scottjulian/OpenTread/hardware/opentread-cyd-case.stl

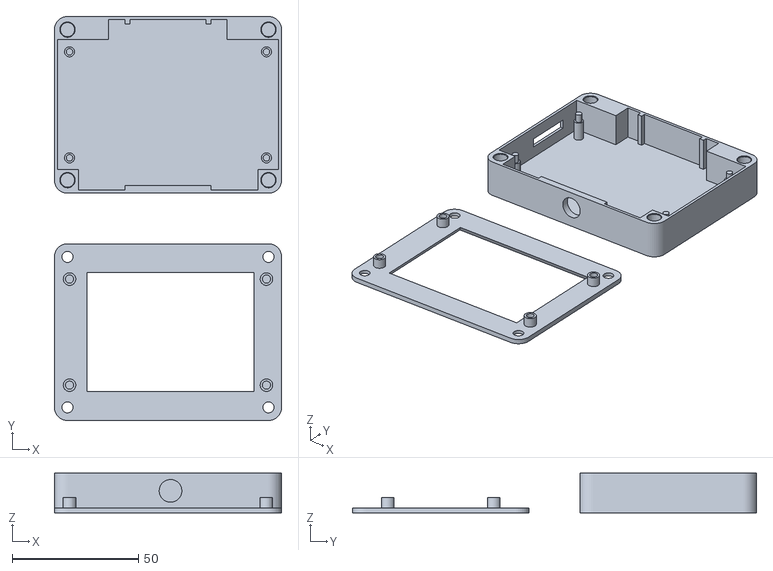
[picture p7: CAD file, 2026-11-01]
hardware/opentread-cyd-case.stl
90.0 x 160.0 x 15.7
