scottjulian/OpenTread/firmware/opentread/test/data/2026-10-18_1315_bench_jumper.csv

# capture_m4.py host_start=2026-10-18T13:15:34-06:00 port=/dev/cu.usbserial-110 baud=115200 session=bench_jumper m_per_pulse=0.62
ets Jul 29 2019 12:21:46
rst:0x1 (POWERON_RESET) | boot:0x13 (SPI_FAST_FLASH_BOOT)
configsip: 0 | SPIWP:0xee
clk_drv:0x00 | q_drv:0x00 | d_drv:0x00 | cs0_drv:0x00 | hd_drv:0x00 | wp_drv:0x00
mode:DIO | clock div:1
load:0x3fff0030 | len:4876
ho 0 tail 12 room 4
load:0x40078000 | len:16532
load:0x40080400 | len:3500
entry 0x400805b4
S | 14260 | M4 pulse logger v1 pin=27 lockout_us=20000 release_us=5000 baud=115200 line_level=1 ring=2048 marker_pin=0 reset_reason=1
S | 14260 | format: E;t;level P;t;n;dt_us F;t;hex M;t;n S;t;text H;t;pulses;edges;drop_e;ftms;drop_f;conn;level
S | 296544 | scan start (boot) for 'AssaultRunner*' - press CONNECT on the console
H | 5299348 | 0 | 0 | 0 | 0 | 0 | 0 | 1
H | 10299347 | 0 | 0 | 0 | 0 | 0 | 0 | 1
H | 15299347 | 0 | 0 | 0 | 0 | 0 | 0 | 1
H | 20299347 | 0 | 0 | 0 | 0 | 0 | 0 | 1
H | 25299347 | 0 | 0 | 0 | 0 | 0 | 0 | 1
H | 30299350 | 0 | 0 | 0 | 0 | 0 | 0 | 1
S | 30300355 | scan start (rescan) for 'AssaultRunner*' - press CONNECT on the console
H | 35299347 | 0 | 0 | 0 | 0 | 0 | 0 | 1
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
