scottjulian/OpenTread/firmware/opentread/test/data/2026-10-18_1323_S1_handturn.csv

# capture_m4.py host_start=2026-10-18T13:23:33-06:00 port=/dev/cu.usbserial-10 baud=115200 session=S1_handturn m_per_pulse=0.62
ets Jul 29 2019 12:21:46
rst:0x1 (POWERON_RESET) | boot:0x13 (SPI_FAST_FLASH_BOOT)
configsip: 0 | SPIWP:0xee
clk_drv:0x00 | q_drv:0x00 | d_drv:0x00 | cs0_drv:0x00 | hd_drv:0x00 | wp_drv:0x00
mode:DIO | clock div:1
load:0x3fff0030 | len:4876
ho 0 tail 12 room 4
load:0x40078000 | len:16532
load:0x40080400 | len:3500
entry 0x400805b4
S | 13494 | M4 pulse logger v1 pin=27 lockout_us=20000 release_us=5000 baud=115200 line_level=1 ring=2048 marker_pin=0 reset_reason=1
S | 13494 | format: E;t;level P;t;n;dt_us F;t;hex M;t;n S;t;text H;t;pulses;edges;drop_e;ftms;drop_f;conn;level
S | 281535 | scan start (boot) for 'AssaultRunner*' - press CONNECT on the console
H | 5284339 | 0 | 0 | 0 | 0 | 0 | 0 | 1
H | 10284337 | 0 | 0 | 0 | 0 | 0 | 0 | 1
S | 11628506 | BLE connecting to fd:a6:3b:08:67:e5 (timeout 5000 ms)
S | 11628505 | scan match: AssaultRunner850809 [fd:a6:3b:08:67:e5]
S | 12052842 | BLE connected mtu=70
S | 12653069 | BLE subscribed to Treadmill Data mtu=70
F | 12752974 | a61400000000000000000000ffffff0800ff7f0000
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
