scottjulian/OpenTread/firmware/opentread/test/data/2026-10-18_1416_S1b_10rev.csv

# capture_m4.py host_start=2026-10-18T14:16:43-06:00 port=/dev/cu.usbserial-10 baud=115200 session=S1b_10rev m_per_pulse=0.62
ets Jul 29 2019 12:21:46
rst:0x1 (POWERON_RESET) | boot:0x13 (SPI_FAST_FLASH_BOOT)
configsip: 0 | SPIWP:0xee
clk_drv:0x00 | q_drv:0x00 | d_drv:0x00 | cs0_drv:0x00 | hd_drv:0x00 | wp_drv:0x00
mode:DIO | clock div:1
load:0x3fff0030 | len:4876
ho 0 tail 12 room 4
load:0x40078000 | len:16532
load:0x40080400 | len:3500
entry 0x400805b4
S | 12784 | M4 pulse logger v1 pin=27 lockout_us=20000 release_us=5000 baud=115200 line_level=1 ring=2048 marker_pin=0 reset_reason=1
S | 12784 | format: E;t;level P;t;n;dt_us F;t;hex M;t;n S;t;text H;t;pulses;edges;drop_e;ftms;drop_f;conn;level
S | 290534 | scan start (boot) for 'AssaultRunner*' - press CONNECT on the console
H | 5293338 | 0 | 0 | 0 | 0 | 0 | 0 | 1
H | 10293337 | 0 | 0 | 0 | 0 | 0 | 0 | 1
M | 14104259 | 1
H | 15293337 | 0 | 0 | 0 | 0 | 0 | 0 | 1
E | 18578332 | 0
P | 18578332 | 1 | 0
E | 18648948 | 1
E | 18648950 | 1
E | 19725310 | 0
P | 19725310 | 2 | 1146978
E | 19770123 | 1
E | 19770125 | 1
H | 20293337 | 2 | 6 | 0 | 0 | 0 | 0 | 1
E | 20731330 | 0
P | 20731330 | 3 | 1006020
E | 20781199 | 1
E | 20781201 | 1
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
