scottjulian/OpenTread/tools/touch_cal.py

#!/usr/bin/env python3
"""Touch calibration from a touch bring-up log (OT_BRINGUP=1 build).

Run with the pinned interpreter, standard library only (writes nothing):

    .venv/bin/python -I tools/touch_cal.py logs/<date>_<time>_<session>.csv
    .venv/bin/python -I tools/touch_cal.py presses.csv --size 320x240 --reff 1
    .venv/bin/python -I tools/touch_cal.py LOG --require-grid      # acceptance run
    .venv/bin/python -I tools/touch_cal.py --self-test

What it computes (from presses whose raw values come from lcd.getTouchRaw()):
  1. Screen-frame fit at the chosen rotation, from the 4 corner + centre
     presses: which raw axis drives screen x / y (axis SWAP) and whether raw
     decreases as the screen coordinate grows (INVERSION); the raw value at
     each screen edge.
  2. The LovyanGFX Touch_XPT2046 config (x_min/x_max/y_min/y_max, i.e. the
     TOUCH_X/Y_MIN/MAX constants) in the library's NATIVE touch frame. These
     depend on the library's effective touch rotation r_eff, taken from touchcfg
     (rot/poff/toff), --reff, or inferred from logged sx/sy.
  3. The 3x3 grid error with those (integer, rounded) constants, through the
     exact LovyanGFX 1.2.26 pipeline (Panel_Device::setCalibrate +
     convertRawXY: per-axis linear map, truncation to int, then r_eff
     swap/flip). Acceptance: every grid point |dx| <= 15 and |dy| <= 15 px.
     Without grid presses: calibration residuals and leave-one-out errors.
  4. TOUCH_Z_MIN from the labelled light/normal/firm x dry/damp presses
     (rule below).

------------------------------------------------------------------------------
INPUT CONTRACT (the firmware's OT_BRINGUP=1 touch screen must produce this;
emitted by firmware/opentread/hw_display.cpp; summarised in its README)
------------------------------------------------------------------------------
Log input = a tools/capture.py log (verbatim serial). Only lines containing one
of the tags `touchcal;`, `touchraw;` or `touchcfg;` are used; every other line
(boot ROM noise, E/P/H/K/D/G/T lines, torn lines) is ignored. Normally these
are S lines, so commas in the text are already ';':

  S,<t_us>,touchcfg;rot=1 poff=2 toff=0 w=320 h=240 pw=240 ph=320 x_min=300 x_max=3900 y_min=3700 y_max=200 zth=0 inset=20 reff=3
  S,<t_us>,touchcal;tgt=tl tx=20 ty=20 x=3712 y=402 z=44 zmin=41 n=25 sx=19 sy=22
  S,<t_us>,touchcal;tgt=z press=light finger=damp x=2010 y=2050 z=39 zmin=37 n=31
  S,<t_us>,touchraw;tgt=g4 tx=160 ty=120 x=2050 y=1980 z=45 sx=161 sy=118

After the tag, the payload is key=value tokens separated by spaces and/or ';'
(order free, unknown keys ignored, keys case-insensitive). Values are
integers (decimals accepted).

touchcfg (optional but strongly recommended; print once at bring-up start and
again whenever any field changes; a press uses the last touchcfg before it):
  rot      lcd.setRotation() value used for the bring-up screen (0..7)
  poff     Panel offset_rotation compiled into LGFX_CYD (0..7)
  toff     Touch_XPT2046 offset_rotation compiled into LGFX_CYD (0..7)
  w,h      logical screen size at rot (lcd.width(), lcd.height())
  pw,ph    panel_width/panel_height in the panel config (240, 320)
  x_min,x_max,y_min,y_max  Touch_XPT2046 config values live NOW (compiled, or
           applied in RAM with setTouchRanges, e.g. the bring-up's 'ka')
  zth      the z threshold the bring-up applied before logging (0 = none)
  inset    corner-target inset in px (only used when tx/ty are absent)
  reff     optional: the effective touch rotation if the firmware computes it
           (else derived from rot/poff/toff with LovyanGFX's own formula)
touchcal (one line per press; the firmware aggregates the samples it took
while the finger was held):
  tgt      target name (required): tl tr bl br c (calibration);
           g0..g8 (3x3 grid, row-major from top-left; g<r><c> also accepted);
           z (pressure test, with press= and finger=; or z_<press>_<finger>);
           any other name with tx/ty = extra check point
  x,y      raw from lcd.getTouchRaw() (median over the held samples; the
           library's own value is already a median of 7 reads) (required)
  z        tp.size from getTouchRaw (median) (required for the z rule)
  zmin     smallest size seen while held, after dropping the first/last 2
           samples (optional; the z rule uses it when present)
  tx,ty    the drawn target centre in logical screen px at rot (strongly
           recommended; defaults: corners at the inset, centre w/2,h/2, grid
           at (2c+1)w/6, (2r+1)h/6)
  sx,sy    lcd.convertRawXY() of the SAME raw x,y (copy the touch_point_t,
           convert the copy), with the compiled constants. NOT a second
           getTouch() call (that is a new, different sample). Optional: used
           to infer/verify r_eff and the library model, and to report the
           device-side grid error.
  press    light | normal | firm   (z tests; optional on other targets)
  finger   dry | damp
  n        samples aggregated (informational)
touchraw (one line per sample while held; the tool groups samples into
presses): same keys as touchcal (z per sample, no zmin/n). A press = a run of
consecutive touchraw lines with the same tgt/press/finger (and id= if given)
whose S-line timestamps are <= 150 ms apart. The first/last 2 samples of a
press are dropped when it has >= 7; then x,y,z = median, zmin = minimum.
Samples with valid=0 are skipped.

RUNS: every `screen;<name>` S line (printed when the firmware switches screens,
e.g. on kc, kg, z<label>, m, r<n>) starts a new run. The firmware restarts the
target sequence on every kc/kg, so, like its own cal;suggest, the tool fits
ONLY the last complete calibration run (all 5 of tl tr br bl c) and scores
ONLY the last complete 3x3 grid run (all 9); earlier runs (a redone kc or kg)
are discarded and counted in the output. Without screen lines (CSV input or
older logs) everything is one run. z presses from every run are used.

CSV input (alternative): a header line with at least target,x_raw,y_raw,z
(aliases: tgt, x, y, size); optional columns tx,ty,sx,sy,zmin,press,finger,n.
'#' lines are comments; a '#' line containing `touchcfg;` is parsed as above.
Each row is one press.

------------------------------------------------------------------------------
TOUCH_Z_MIN RULE
------------------------------------------------------------------------------
z is LovyanGFX's tp.size = (0x3200 + y - x + ((z1 - z2) >> 1)) >> 8 (median
of 7), so it depends on POSITION as well as pressure (raw y - x spans ~+-3700,
i.e. ~+-14 size units, comparable to the light..firm spread). Therefore:
  a. Position model f(x,y) = bx*x + by*y. Fitted by least squares on the
     calibration/grid presses plus presses labelled normal, when there are
     >= 9 of them spanning >= 1500 raw units in both x and y; otherwise the
     library's explicit term (bx, by) = (-1/256, +1/256).
  b. Every deliberate press i (all labelled presses AND all calibration/grid
     presses) is moved to the worst position on the screen:
         z_worst_i = zuse_i + min over the 4 screen corners c of f(c) - f(p_i)
     where zuse = zmin if logged, else z, and the corners' raw values come
     from the screen-frame fit.
  c. L = min_i z_worst_i (the weakest deliberate press at the worst place).
     TOUCH_Z_MIN = max(1, floor(L) - Z_MARGIN), Z_MARGIN = 2 size units (one
     unit of >>8 quantisation plus one of headroom). The touch debounce
     (3 consecutive valid samples, 120 ms release bridge) handles noise, so
     the threshold is biased to ACCEPT light/damp presses.
  Warnings: a light/normal/firm x dry/damp class missing; per-finger medians
  not light <= normal <= firm; the weakest raw z within 1 unit of the
  bring-up's zth (light presses may have been censored: rerun with zth=0).

TOUCH_Z_MIN needs the screen fit (the kc presses) in the SAME capture as the
z presses: without it no recommendation is printed (FAIL).

Exit code: 0 = calibration computed and, if grid presses exist, all within
tolerance; 1 = grid out of tolerance, missing/insufficient calibration,
inconsistent rotation, or --require-grid without a full grid; 2 = usage or
file error. --self-test runs synthetic cases (all 8 r_eff values incl.
rotated and inverted axes, each input format, injected faults).
"""
from __future__ import annotations

import argparse
import csv
import math
import os
import random
import re
import statistics
import sys
from dataclasses import dataclass, field

sys.dont_write_bytecode = True

# --------------------------------------------------------------------------
# Constants
# --------------------------------------------------------------------------
DEFAULT_W, DEFAULT_H = 320, 240        # landscape (rotation 1 or 3) logical screen
DEFAULT_PW, DEFAULT_PH = 240, 320      # ILI9341 panel_width / panel_height
START_CFG = {"x_min": 300, "x_max": 3900, "y_min": 3700, "y_max": 200}  # uncalibrated start values
DEFAULT_INSET = 20
GRID_TOL_PX = 15                       # acceptance: 3x3 grid within +-15 px
RAW_VALID_LO, RAW_VALID_HI = 129, 3968 # Touch_XPT2046::getTouchRaw keeps 128 < v <= 3968
Z_MARGIN = 2
GAP_MS = 150
TRIM = 2
TRIM_MIN_SAMPLES = 2 * TRIM + 3
LIB_BX, LIB_BY = -1.0 / 256.0, 1.0 / 256.0
POS_FIT_MIN_N, POS_FIT_MIN_SPAN = 9, 1500
MODEL_TOL_PX = 2.5                     # sx/sy vs exact library model, rms
PRESS_CLASSES = ("light", "normal", "firm")
FINGERS = ("dry", "damp")
CAL_TARGETS = ("tl", "tr", "bl", "br", "c")
GRID_TARGETS = tuple(f"g{i}" for i in range(9))

_ALIASES = {"ul": "tl", "lt": "tl", "topleft": "tl", "top_left": "tl",
            "ur": "tr", "rt": "tr", "topright": "tr", "top_right": "tr",
            "ll": "bl", "lb": "bl", "bottomleft": "bl", "bottom_left": "bl",
            "lr": "br", "rb": "br", "bottomright": "br", "bottom_right": "br",
            "cc": "c", "ctr": "c", "center": "c", "centre": "c", "mid": "c", "m": "c"}
_KEY_ALIASES = {"target": "tgt", "x_raw": "x", "y_raw": "y", "xr": "x", "yr": "y",
                "rx": "x", "ry": "y", "size": "z", "z_raw": "z", "pressure": "press",
                "z_min": "zmin", "rotation": "rot"}
_TAG_RE = re.compile(r"(?:^|[\s;:,])(touchcal|touchraw|touchcfg)[;:\s]")
_SCREEN_RE = re.compile(r"(?:^|[\s;:,])screen;([a-z_]+)")
_S_RE = re.compile(r"^S,(\d+),")
_NUM_RE = re.compile(r"^[+-]?\d+(\.\d+)?$")


class InputError(Exception):
    pass


# --------------------------------------------------------------------------
# Data
# --------------------------------------------------------------------------
@dataclass
class Cfg:
    rot: int | None = None
    poff: int | None = None
    toff: int | None = None
    reff: int | None = None
    w: int = DEFAULT_W
    h: int = DEFAULT_H
    pw: int = DEFAULT_PW
    ph: int = DEFAULT_PH
    consts: dict | None = None       # x_min.. compiled in the firmware (None = unknown)
    zth: float | None = None
    inset: int = DEFAULT_INSET
    line: int = 0

    def geom_key(self):
        return (self.rot, self.poff, self.toff, self.reff, self.w, self.h, self.pw, self.ph)


@dataclass
class Press:
    tgt: str
    kind: str                      # cal | grid | z | check
    x: float
    y: float
    z: float | None
    zmin: float | None = None
    tx: float | None = None
    ty: float | None = None
    sx: float | None = None
    sy: float | None = None
    press: str | None = None
    finger: str | None = None
    n: int = 1
    line: int = 0
    cfg: Cfg = field(default_factory=Cfg)
    default_target: bool = False
    run: int = 0                   # screen run (see RUNS in the header)


@dataclass
class Capture:
    presses: list
    cfgs: list
    warnings: list
    n_bad: int = 0
    n_tagged: int = 0
    fmt: str = "log"


def combine_rot(a: int, b: int) -> int:
    """LovyanGFX: ((r + offset) & 3) | ((r & 4) ^ (offset & 4))."""
    return ((a + b) & 3) | ((a & 4) ^ (b & 4))


def vflip(r: int) -> bool:
    return bool((1 << r) & 0b10010110)          # r = 1, 2, 4, 7


def cfg_reff(cfg: Cfg):
    if cfg.reff is not None:
        return cfg.reff & 7
    if cfg.rot is None:
        return None
    panel_r = combine_rot(cfg.rot & 7, (cfg.poff or 0) & 7)
    return combine_rot(panel_r, (cfg.toff or 0) & 7)


def touch_dims(cfg: Cfg, toff=None):
    toff = cfg.toff if toff is None else toff
    return (cfg.ph, cfg.pw) if (toff or 0) & 1 else (cfg.pw, cfg.ph)


def reff_valid(r: int, cfg: Cfg) -> bool:
    tw, th = touch_dims(cfg)
    return ((th, tw) if r & 1 else (tw, th)) == (cfg.w, cfg.h)


# --------------------------------------------------------------------------
# Parsing (never raises on bad lines; counts them)
# --------------------------------------------------------------------------
def _num(v):
    v = v.strip()
    if not _NUM_RE.match(v):
        raise ValueError(v)
    f = float(v)
    return int(f) if f.is_integer() else f


def parse_kv(payload: str) -> dict:
    out = {}
    for tok in re.split(r"[;\s]+", payload.strip()):
        if "=" not in tok:
            continue
        k, _, v = tok.partition("=")
        k = k.strip().lower()
        k = _KEY_ALIASES.get(k, k)
        if k:
            out[k] = v.strip()
    return out


def canon_target(name: str, kv: dict):
    """-> (tgt, kind, press, finger)."""
    n = name.strip().lower()
    n = _ALIASES.get(n, n)
    press = (kv.get("press") or "").lower() or None
    finger = (kv.get("finger") or "").lower() or None
    if n in CAL_TARGETS:
        return n, "cal", press, finger
    m = re.fullmatch(r"g(\d)", n)
    if m:
        return f"g{m.group(1)}", "grid", press, finger
    m = re.fullmatch(r"g([0-2])([0-2])", n)
    if m:
        return f"g{3 * int(m.group(1)) + int(m.group(2))}", "grid", press, finger
    if n == "z" or n.startswith("z_") or n.startswith("z-"):
        for part in re.split(r"[_-]", n)[1:]:
            if part in PRESS_CLASSES:
                press = press or part
            elif part in FINGERS:
                finger = finger or part
        return "z", "z", press, finger
    if press in PRESS_CLASSES:
        return n, "z", press, finger
    return n, "check", press, finger


def _cfg_from_kv(kv: dict, base: Cfg, line: int) -> Cfg:
    c = Cfg(rot=base.rot, poff=base.poff, toff=base.toff, reff=base.reff, w=base.w, h=base.h,
            pw=base.pw, ph=base.ph, consts=dict(base.consts) if base.consts else None,
            zth=base.zth, inset=base.inset, line=line)
    for k in ("rot", "poff", "toff", "reff"):
        if k in kv:
            setattr(c, k, int(_num(kv[k])))
    for k in ("w", "h", "pw", "ph", "inset"):
        if k in kv:
            setattr(c, k, int(_num(kv[k])))
    if "zth" in kv:
        c.zth = _num(kv["zth"])
    ck = [k for k in ("x_min", "x_max", "y_min", "y_max") if k in kv]
    if ck:
        if len(ck) != 4:
            raise ValueError("touchcfg needs all of x_min x_max y_min y_max")
        c.consts = {k: int(_num(kv[k])) for k in ("x_min", "x_max", "y_min", "y_max")}
    return c


def _press_from_kv(kv: dict, cfg: Cfg, line: int, need_z=False) -> Press:
    if "tgt" not in kv:
        raise ValueError("no tgt")
    tgt, kind, press, finger = canon_target(kv["tgt"], kv)
    x, y = _num(kv["x"]), _num(kv["y"])
    z = _num(kv["z"]) if kv.get("z", "") != "" else None
    if need_z and z is None:
        raise ValueError("no z")

    def opt(k):
        return _num(kv[k]) if kv.get(k, "") != "" else None
    return Press(tgt=tgt, kind=kind, x=x, y=y, z=z, zmin=opt("zmin"), tx=opt("tx"), ty=opt("ty"),
                 sx=opt("sx"), sy=opt("sy"), press=press, finger=finger,
                 n=int(opt("n") or 1), line=line, cfg=cfg)


def _group_raw(samples, warnings):
    """samples: [(t_us|None, line, kv, cfg, run)] in file order -> [Press]."""
    presses, cur, last_key, last_t = [], [], None, None

    def flush():
        if not cur:
            return
        ps = cur
        if len(ps) >= TRIM_MIN_SAMPLES:
            ps = ps[TRIM:-TRIM]
        base = ps[0][2]
        p = _press_from_kv(base, ps[0][3], ps[0][1])
        p.x = statistics.median(_num(s[2]["x"]) for s in ps)
        p.y = statistics.median(_num(s[2]["y"]) for s in ps)
        zs = [_num(s[2]["z"]) for s in ps if s[2].get("z", "") != ""]
        p.z = statistics.median(zs) if zs else None
        p.zmin = min(zs) if zs else None
        for k in ("sx", "sy"):
            vs = [_num(s[2][k]) for s in ps if s[2].get(k, "") != ""]
            setattr(p, k, statistics.median(vs) if vs else None)
        p.n = len(ps)
        p.run = ps[0][4]
        presses.append(p)

    for t, line, kv, cfg, run in samples:
        key = (kv.get("tgt", "").lower(), kv.get("press"), kv.get("finger"), kv.get("id"), id(cfg), run)
        gap = (t is not None and last_t is not None and t - last_t > GAP_MS * 1000)
        if key != last_key or gap:
            flush()
            cur = []
        cur.append((t, line, kv, cfg, run))
        last_key, last_t = key, t
    flush()
    return presses


def parse_lines(lines, base_cfg: Cfg | None = None) -> Capture:
    base_cfg = base_cfg or Cfg()
    cap = Capture(presses=[], cfgs=[base_cfg], warnings=[])
    first = next((ln.strip() for ln in lines if ln.strip() and not ln.lstrip().startswith("#")), "")
    head = [c.strip().lower() for c in first.split(",")]
    if any(c in ("target", "tgt") for c in head) and any(c in ("x_raw", "x") for c in head):
        return _parse_csv(lines, base_cfg, cap)

    cfg = base_cfg
    raw_samples = []
    run = 0
    for i, raw in enumerate(lines, 1):
        ln = raw.rstrip("\r\n").replace("\r", "")
        m = _TAG_RE.search(ln)
        if not m:
            if _SCREEN_RE.search(ln):
                run += 1
            continue
        cap.n_tagged += 1
        tag = m.group(1)
        sm = _S_RE.match(ln)
        t = int(sm.group(1)) if sm else None
        kv = parse_kv(ln[m.end():])
        try:
            if tag == "touchcfg":
                cfg = _cfg_from_kv(kv, cfg, i)
                cap.cfgs.append(cfg)
            elif tag == "touchcal":
                pr = _press_from_kv(kv, cfg, i)
                pr.run = run
                cap.presses.append(pr)
            else:
                if kv.get("valid", "1") in ("0", "false"):
                    continue
                for k in ("tgt", "x", "y"):
                    if k not in kv:
                        raise ValueError(f"no {k}")
                _num(kv["x"]), _num(kv["y"])
                if kv.get("z", "") != "":
                    _num(kv["z"])
                raw_samples.append((t, i, kv, cfg, run))
        except (ValueError, KeyError) as e:
            cap.n_bad += 1
            if cap.n_bad <= 5:
                cap.warnings.append(f"line {i}: malformed {tag} line ignored ({e}): {ln[:100]}")
    cap.presses.extend(_group_raw(raw_samples, cap.warnings))
    cap.presses.sort(key=lambda p: p.line)
    return cap


def _parse_csv(lines, cfg: Cfg, cap: Capture) -> Capture:
    cap.fmt = "csv"
    body = []
    for i, raw in enumerate(lines, 1):
        ln = raw.rstrip("\r\n")
        if not ln.strip():
            continue
        if ln.lstrip().startswith("#"):
            m = _TAG_RE.search(ln)
            if m and m.group(1) == "touchcfg":
                try:
                    cfg = _cfg_from_kv(parse_kv(ln[m.end():]), cfg, i)
                    cap.cfgs.append(cfg)
                except ValueError as e:
                    cap.n_bad += 1
                    cap.warnings.append(f"line {i}: malformed touchcfg ignored ({e})")
            continue
        body.append((i, ln))
    rd = csv.reader([b for _, b in body])
    header = None
    for (i, _), row in zip(body, rd):
        if header is None:
            header = [_KEY_ALIASES.get(c.strip().lower(), c.strip().lower()) for c in row]
            continue
        kv = {k: v for k, v in zip(header, row) if v.strip() != ""}
        try:
            cap.presses.append(_press_from_kv(kv, cfg, i))
        except (ValueError, KeyError) as e:
            cap.n_bad += 1
            if cap.n_bad <= 5:
                cap.warnings.append(f"line {i}: malformed CSV row ignored ({e})")
    return cap


# --------------------------------------------------------------------------
# Geometry
# --------------------------------------------------------------------------
def default_target(p: Press, cfg: Cfg):
    W, H, a = cfg.w, cfg.h, cfg.inset
    if p.kind == "cal":
        return {"tl": (a, a), "tr": (W - 1 - a, a), "bl": (a, H - 1 - a),
                "br": (W - 1 - a, H - 1 - a), "c": (W // 2, H // 2)}[p.tgt]
    if p.kind == "grid":
        k = int(p.tgt[1:])
        r, c = divmod(k, 3)
        return (round((2 * c + 1) * W / 6), round((2 * r + 1) * H / 6))
    return None


def fit_line(pairs):
    """Least squares screen = m*raw + c over [(raw, screen)] -> (m, c, sse)."""
    n = len(pairs)
    mr = sum(r for r, _ in pairs) / n
    ms = sum(s for _, s in pairs) / n
    sxx = sum((r - mr) ** 2 for r, _ in pairs)
    if sxx == 0:
        raise InputError("degenerate fit: identical raw values")
    m = sum((r - mr) * (s - ms) for r, s in pairs) / sxx
    c = ms - m * mr
    sse = sum((m * r + c - s) ** 2 for r, s in pairs)
    return m, c, sse


@dataclass
class ScreenCal:
    swap: bool                 # True: screen x <- raw y, screen y <- raw x
    mx: float
    cx: float
    my: float
    cy: float
    sse: float
    sse_other: float
    W: int
    H: int

    def src(self, axis):       # raw axis driving screen axis 'x'/'y'
        return ("y" if self.swap else "x") if axis == "x" else ("x" if self.swap else "y")

    def raw_at(self, axis, s):
        m, c = (self.mx, self.cx) if axis == "x" else (self.my, self.cy)
        return (s - c) / m

    def edges(self):
        return {"x0": self.raw_at("x", 0), "x1": self.raw_at("x", self.W - 1),
                "y0": self.raw_at("y", 0), "y1": self.raw_at("y", self.H - 1)}

    def int_edges(self):
        return {k: int(round(v)) for k, v in self.edges().items()}

    def map_int(self, rx, ry):
        """Screen-frame integer pipeline (same arithmetic as LovyanGFX)."""
        e = self.int_edges()
        ax, ay = (ry, rx) if self.swap else (rx, ry)
        sx = math.trunc((ax - e["x0"]) * (self.W - 1) / (e["x1"] - e["x0"]))
        sy = math.trunc((ay - e["y0"]) * (self.H - 1) / (e["y1"] - e["y0"]))
        return sx, sy

    def corners_raw(self):
        out = []
        for sx in (0, self.W - 1):
            for sy in (0, self.H - 1):
                a, b = self.raw_at("x", sx), self.raw_at("y", sy)
                out.append((b, a) if self.swap else (a, b))   # (raw x, raw y)
        return out
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
