scottjulian/OpenTread/(commit log)

2026-10-29 OpenTread 1.0.0
    Open-source replacement console for the AssaultRunner curved manual
    treadmill: ESP32 CYD firmware (reed-sensor pulse filter, workout state
    machine, touch UI, BLE RSC footpod + FTMS treadmill), host tests with a
    reference oracle and emulation, build/capture/replay/BLE tools, and docs.
2026-11-01 Add the 3D-printed case and photos
    hardware/opentread-cyd-case.stl is a case and front bezel for the
    two-USB ESP32-2432S028R. It mounts on the stock console's holes with the
    console's own M5 screws, using M4 and M5 heat-set inserts. The README's
    Hardware section gains a 3D-printed case subsection with its parts and
    three photos of it on the treadmill.
2026-11-01 Move the 3D-printed case section after Using it
    It's optional, so it now follows the setup and usage steps instead of
    sitting in the middle of Hardware.
